tiborkiss/lora-tracker-kicad/träcker 01.pdf

# zukunftstag 2026

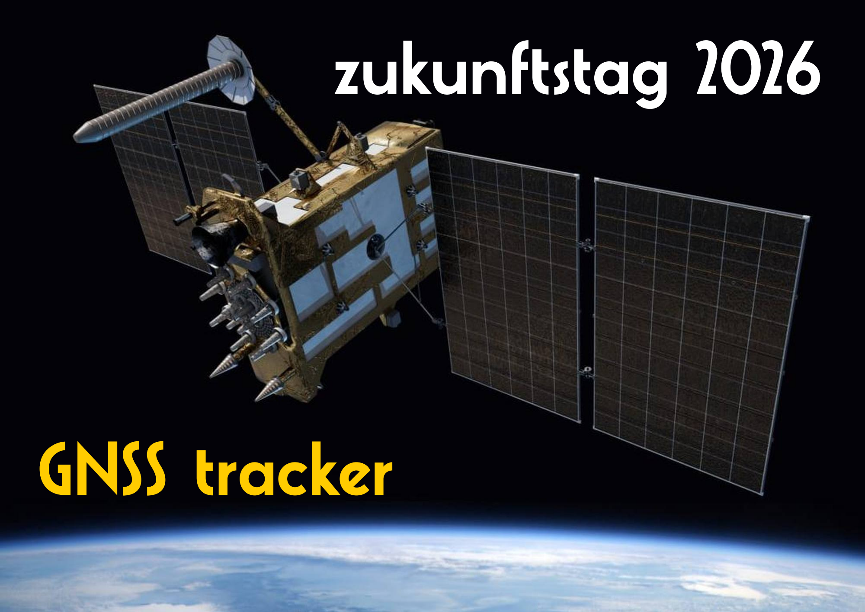
[picture p1: page 1]

# GNSS tracker

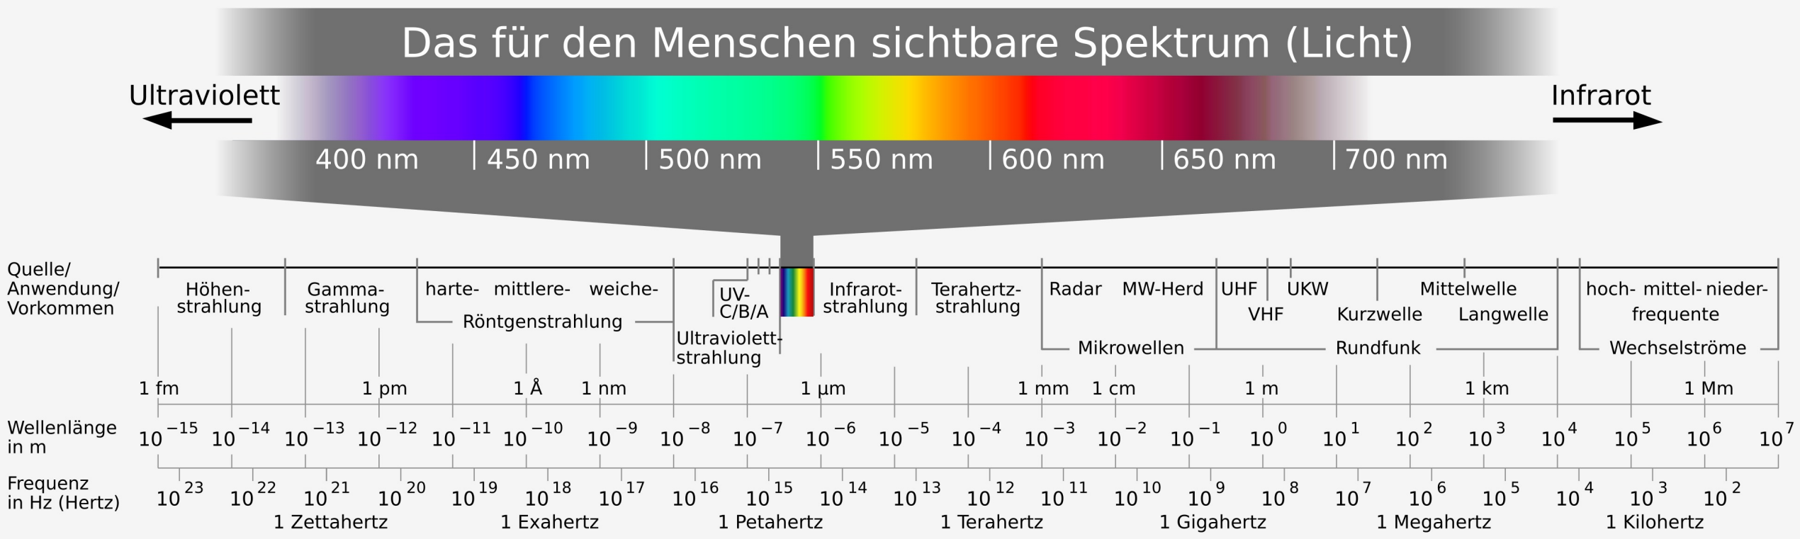
[picture p2: figure]

für den zukunftstag bauen wir einen tracker und einen empfänger. der tracker sendet seine position dem empfänger der diese in seinem display als zwei winkel anzeigt - azimut und deklination oder höhe und breite.

für die positionsbestimmung und die positionsübertragung nutzen wir elektromagnetische wellen.

ein teilspektrum der elektromagnetische wellen kann man sehen, dieser bereich ist licht. es hat sehr kurze wellenlängen < 1mikrometer.
die wellenlängen welches wir für die unser projekt nutzen sind im bereich von dezimeter.

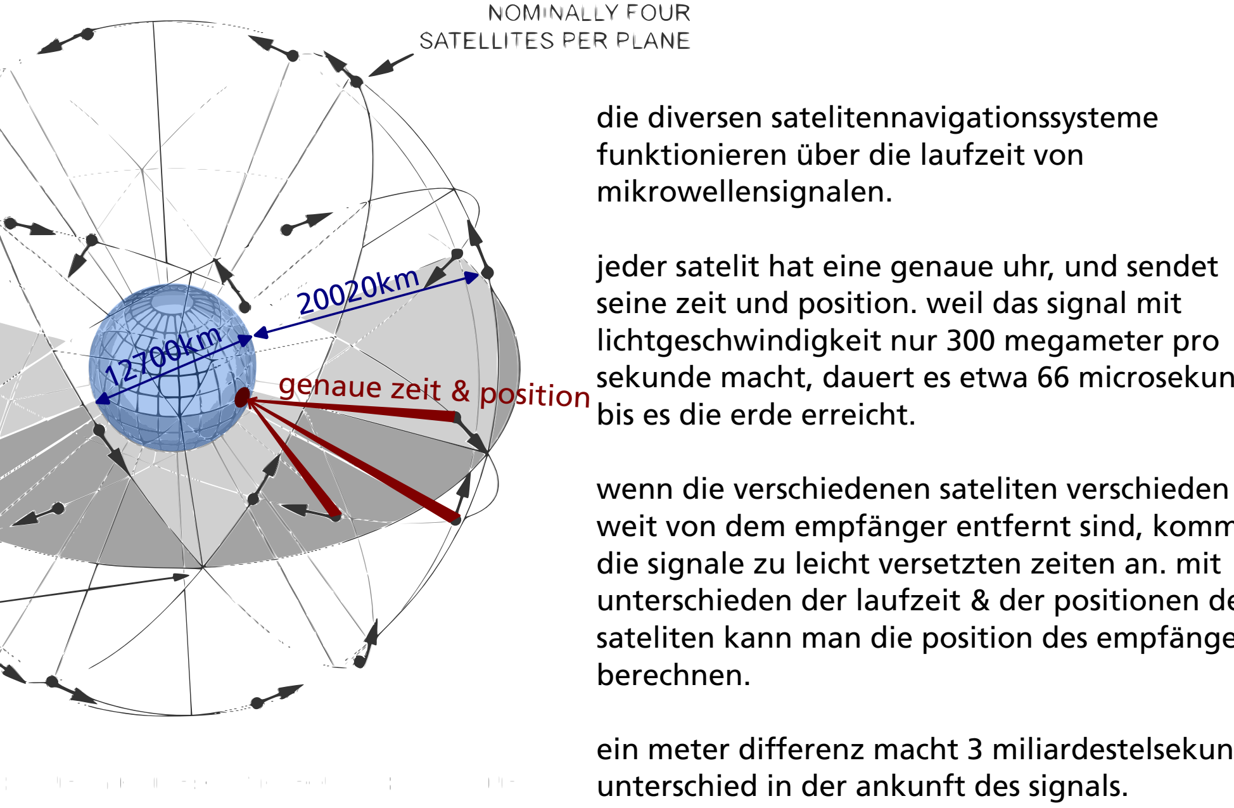
[picture p3: figure]
genaue zeit & position; die diversen satelitennavigationssysteme funktionieren über die laufzeit von mikrowellensignalen.; lichtgeschwindigkeit nur 300 megameter pro; bis es die erde erreicht.; wenn die verschiedenen sateliten verschieden; berechnen.; unterschied in der ankunft des signals.

jeder satelit hat eine genaue uhr, und sendet seine zeit und position. weil das signal mit

sekunde macht, dauert es etwa 66 microsekunden

weit von dem empfänger entfernt sind, kommen die signale zu leicht versetzten zeiten an. mit unterschieden der laufzeit & der positionen der sateliten kann man die position des empfängers

ein meter differenz macht 3 miliardestelsekunden für die übertragung der positiondaten muss der tracker selber senden.

es gibt einige frequenzbereiche welche frei verwendet werden dürfen, und mit diesen kann man kommunizieren ohne einen telefonanbieter oder eine behörde bezahlen zu müssen.

auf 989MHz kann man mit 0.5 watt strahlen und 100 zeichen pro sekunde bis 200km übertragen.

dies funktioniert nur wenn man freie sicht hat & eine freie fresnelzone. zum beispiel ein 30m freier radius für 10km distanz.

wenn objekte in diesem bereich sind, wird eine teil der gesendeten elektromagnetischen leistung absorbiert und in wärme verwandelt, oder in eine andere richtung abgelenkt. damit wird die mögliche übertragnungsdistanz kleiner, denn das signal geht im rauschen unter.

30m

10km

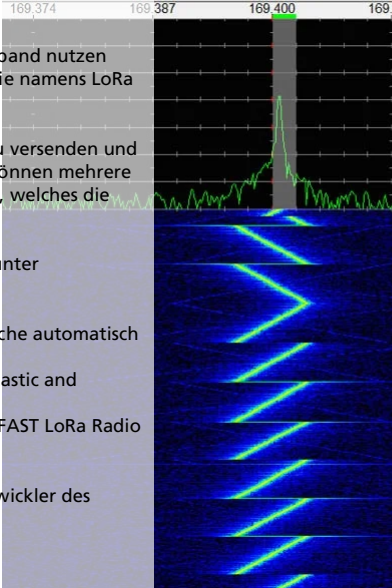
[picture p4: figure]

das funkprotokoll welches wir auf dem gratisband nutzen heisst mestastic. es verwendet eine technologie namens LoRa (long range).

das protokoll ermöglicht kurze nachrichten zu versenden und empfangene nachrichten weiterzuleiten. so können mehrere mestastic geräte spontan ein netzwerk bilden, welches die mögliche übertragnungsdistanz vervielfacht.

informationen zu dem protokoll findet man unter

1. https://swiss-mesh.ch/de/
2. viele vidos auf youtube.com (untertitel welche automatisch übersetzt werden können)
"Intro to LoRa Mesh Part 1: What are Meshtastic and MeshCore?"
"Meshtastic Signal Identification for LONG_FAST LoRa Radio Presets on SDR"
3. https://meshtastic.org/ (english)
4. https://www.semtech.com/lora (english entwickler des protokolls)

## Bestückung Tracker

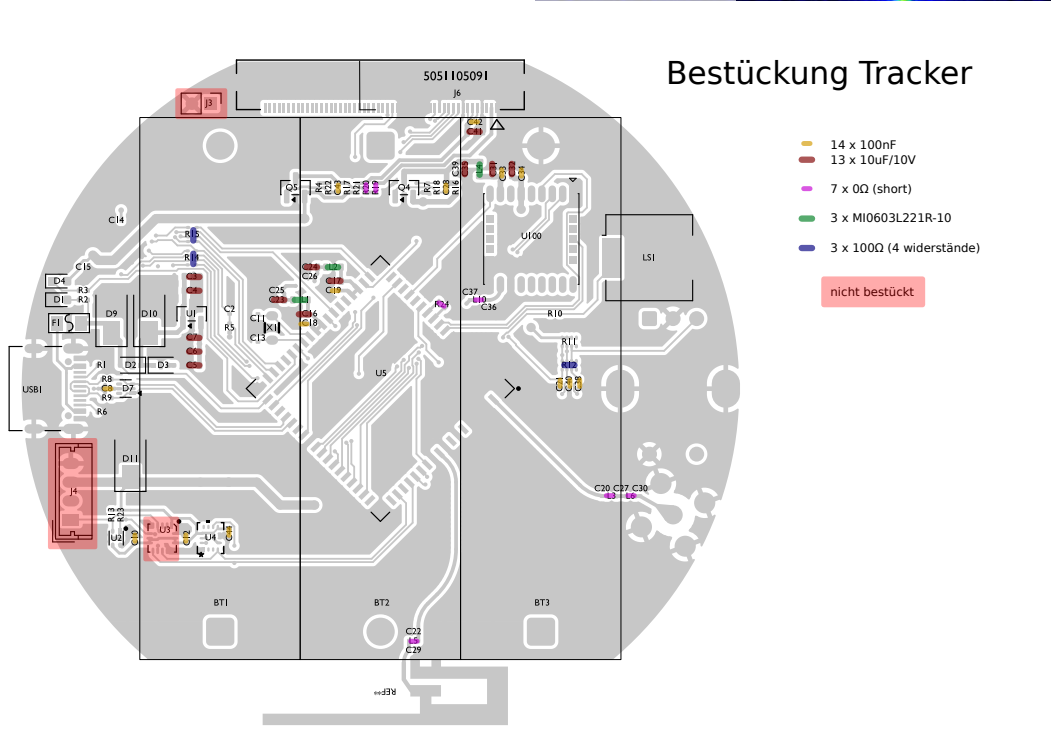
[picture p5: page 6]
7 x 0Ω (short); 3 x 100Ω (4 widerstände); nicht bestückt

## Bestückung Empfänger

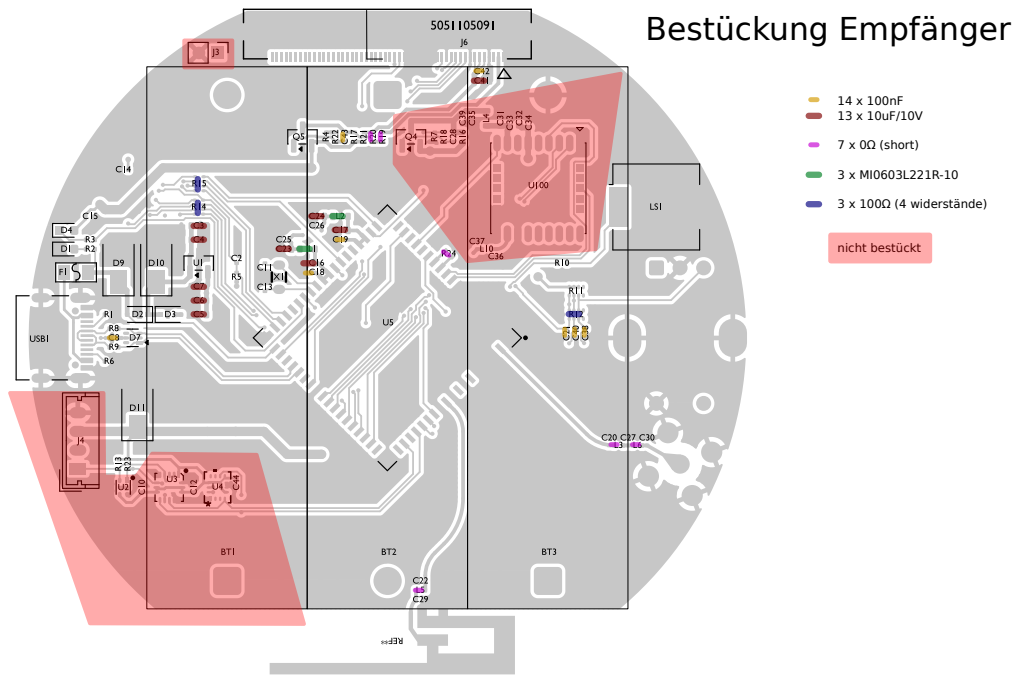
[picture p6: page 7]
7 x 0Ω (short); 3 x 100Ω (4 widerstände); nicht bestückt

Qty | Value | Reference | Footprint
| | orientierung egal
14 | 100n | C8,C10,C12,C18,C19,C21,C28,C33,C34,C38,C40,C42,C43,C44 | CSC01:0402_C
13 | 10u/10V | C3,C4,C5,C6,C7,C16,C17,C23,C24,C31,C32,C35,C41 | CSC01:0603_C
4 | SHORT | L3,L5,L6,L10 | CSC01:0402_L
4 | 2k2 | R13,R18,R22,R23 | CSC01:0402_R
3 | SHORT | R19,R20,R24 | CSC01:0402_R
3 | MI0603L221R-10 | L1,L2,L4 | CSC01:0603_L
3 | 100 | R12,R14,R15 | CSC01:0804-8
2 | 1p0 | C11,C13 | CSC01:0402_C
2 | GSEZ7B002 | C30,C37 | CSC01:0402_C
2 | 22 | R8,R9 | CSC01:0402_R
2 | 220 | R3,R10 | CSC01:0402_R
2 | 100k | R4,R7 | CSC01:0402_R
2 | 5k1 | R1,R6 | CSC01:0402_R
1 | 1k | R2 | CSC01:0402_R
1 | 10k | R11 | CSC01:0804-8
1 | SC32S-7PF20PPM | X1 | CSC01:XTAL2-1.5X3.2
1 | 0ZCJ0025FF2E | F1 | demo:FS1206
1 | CPT-9019 | LS1 | BuzzerCUI_CPT-9019S-SMT
| | polarisiert
2 | B0530WS RRG | D2,D3 | CSC01:D_SOD-323F
2 | SMAJ5.0A | D9,D10 | Diode_SMD:D_SMA
2 | IN-S63AT5A | D1,D4 | LED_0603_1608Metric
1 | D5V0F4U6V | D7 | SOT-563
1 | SMBJ3V3-E3/52 | D11 | Diode_SMD:D_SMA
2 | SLMT320V3CP | Q4,Q5 | Package_TO_SOT_SMD:SOT-23

1 | LC76G | U100 | 000:LC76G
1 | BMI270 | U4 | 000:BMI270_BOS
1 | SHT41 | U2 | demo:SNR4-0.8-1.5X1.5X0.54MM
1 | WM1110-A_01 | U5 | MODULE72_0D9_20X20X2MM
1 | AP7333-33SAG-7 | U1 | Package_TO_SOT_SMD:SOT-23
1 | UBF31-0171 | USB1 | demo:USB2.0-TYPE-C
1 | 5051102891 | J6 | 000:CON_5051105091_MOL
| | erst nach reflow löten besücken
3 | Battery_Cell AA | BT1,BT2,BT3 | GNSS_tracker:keystone_2460
1 | PEC12R-4222F-S0024 | SW3 | 000:RotaryEncoder
1 | Conn_Coaxial | J2 | Connector_Coaxial:SMA
1 | ANT 2525 B 00B T 15AE1 | ANT 2525 B 00B T 1575S
| | nicht bestückt
11 | NC | C2,C14,C15,C20,C22,C25,C26,C27,C29,C36,C39 | CSC01:0402_C
4 | NC | R5,R16,R17,R21 | CSC01:0402_R
1 | NC | J4 | Connector_Molex:Molex
1 | NC | J1 | Connector_PinHeader_1.27mm
1 | NC | J3 | Connector_PinHeader_2.00mm
1 | NC (H3LIS331DL) | U3 | demo:LGA16-0.5-3X3MM

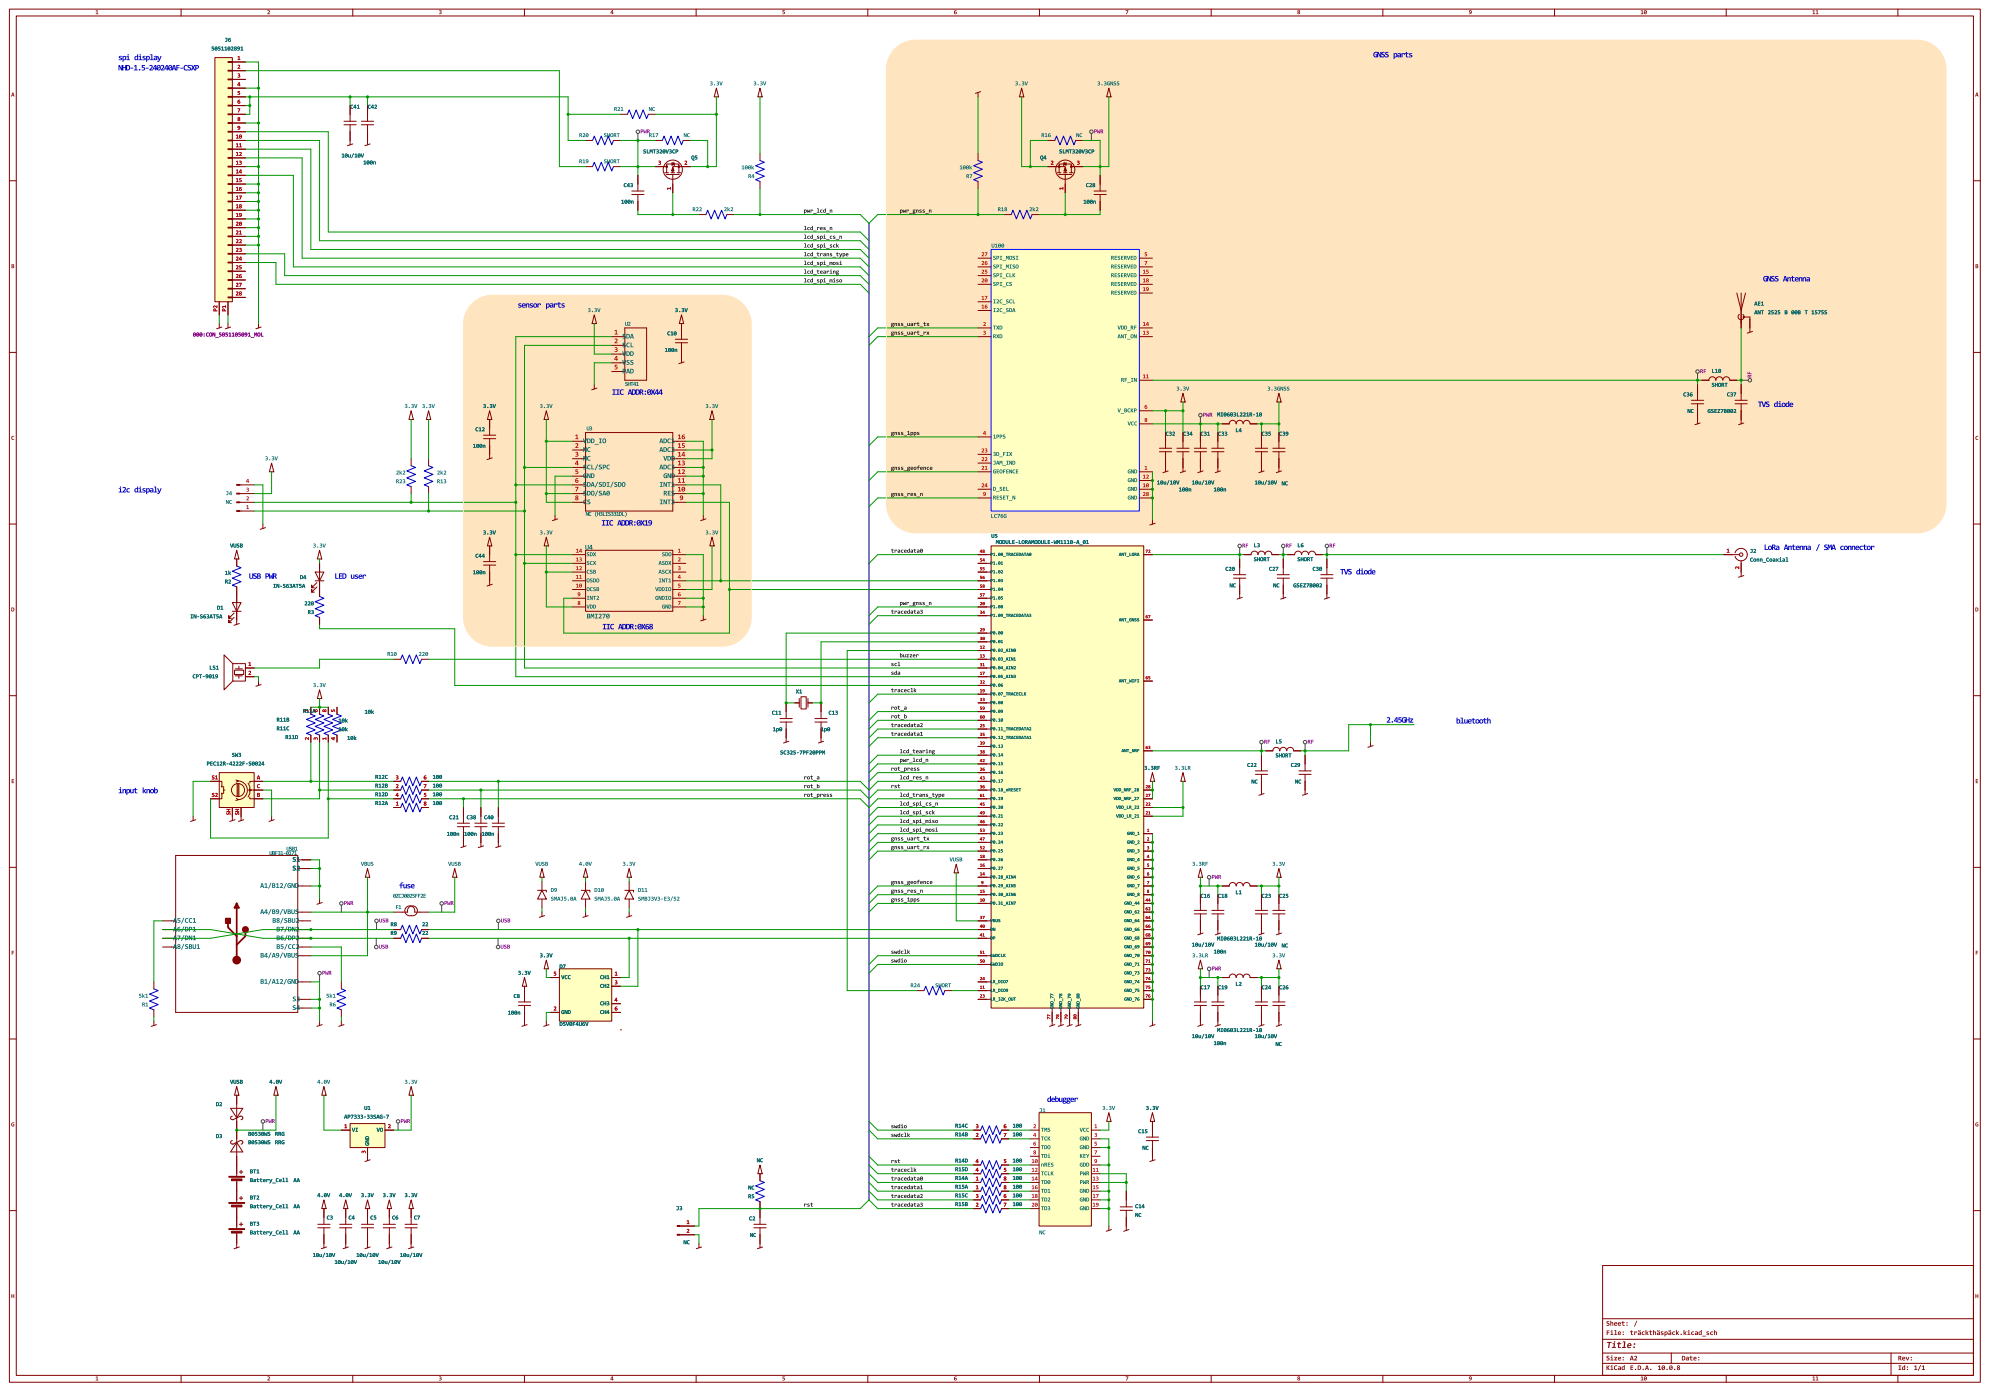
[picture p7: page 10]
