tiborkiss/lora-tracker-kicad/träckthäspäck.csv

Qty | Reference | Value | Footprint
 | orientierung egal
14 | C8,C10,C12,C18,C19,C21,C28,C33,C34,C38,C40,C42,C43,C44 | 100n | CSC01:0402_C
13 | C3,C4,C5,C6,C7,C16,C17,C23,C24,C31,C32,C35,C41 | 10u/10V | CSC01:0603_C
4 | L3,L5,L6,L10 | SHORT | CSC01:0402_L
4 | R13,R18,R22,R23 | 2k2 | CSC01:0402_R
3 | R19,R20,R24 | SHORT | CSC01:0402_R
3 | L1,L2,L4 | MI0603L221R-10 | CSC01:0603_L
3 | R12,R14,R15 | 100 | CSC01:0804-8
2 | C11,C13 | 1p0 | CSC01:0402_C
2 | C30,C37 | GSEZ7B002 | CSC01:0402_C
2 | R8,R9 | 22 | CSC01:0402_R
2 | R3,R10 | 220 | CSC01:0402_R
2 | R4,R7 | 100k | CSC01:0402_R
2 | R1,R6 | 5k1 | CSC01:0402_R
1 | R2 | 1k | CSC01:0402_R
1 | R11 | 10k | CSC01:0804-8
1 | X1 | SC32S-7PF20PPM | CSC01:XTAL2-1.5X3.2
1 | F1 | 0ZCJ0025FF2E | demo:FS1206
1 | LS1 | CPT-9019 | Buzzer_Beeper:Buzzer_CUI_CPT-9019S-SMT
 | polarisiert
2 | D2,D3 | B0530WS RRG | CSC01:D_SOD-323F
2 | D9,D10 | SMAJ5.0A | Diode_SMD:D_SMA
2 | D1,D4 | IN-S63AT5A | LED_SMD:LED_0603_1608Metric
1 | D7 | D5V0F4U6V | SOT-563
1 | D11 | SMBJ3V3-E3/52 | Diode_SMD:D_SMA
2 | Q4,Q5 | SLMT320V3CP | Package_TO_SOT_SMD:SOT-23
1 | U100 | LC76G | 000:LC76G
1 | U4 | BMI270 | 000:BMI270_BOS
1 | U2 | SHT41 | demo:SNR4-0.8-1.5X1.5X0.54MM
1 | U5 | MODULE-LORAMODULE-WM1110-A_01 | MODULE72_0D9_20X20X2MM
1 | U1 | AP7333-33SAG-7 | Package_TO_SOT_SMD:SOT-23
1 | USB1 | UBF31-0171 | demo:USB2.0-TYPE-C
1 | J6 | 5051102891 | 000:CON_5051105091_MOL
 | erst nach reflow löten besücken
3 | BT1,BT2,BT3 | Battery_Cell AA | GNSS_tracker:keystone_2460
1 | SW3 | PEC12R-4222F-S0024 | 000:RotaryEncoder_Bourns_Vertical_PEC12R-3x17F-S--oli
1 | J2 | Conn_Coaxial | Connector_Coaxial:SMA_Amphenol_132134_Vertical
1 | AE1 | ANT 2525 B 00B T 1575S | GNSS_tracker:ANT 2525 B 00B T 1575S
 | nicht bestückt
11 | C2,C14,C15,C20,C22,C25,C26,C27,C29,C36,C39 | NC | CSC01:0402_C
4 | R5,R16,R17,R21 | NC | CSC01:0402_R
1 | J4 | NC | Connector_Molex:Molex_Micro-Latch_53253-0470_1x04_P2.00mm_Vertical
1 | J1 | NC | Connector_PinHeader_1.27mm:PinHeader_2x10_P1.27mm_Vertical_SMD
1 | J3 | NC | Connector_PinHeader_2.00mm:PinHeader_1x02_P2.00mm_Vertical
1 | U3 | NC (H3LIS331DL) | demo:LGA16-0.5-3X3MM
