tiborkiss/lora-tracker-kicad/träckthäspäck.kicad_pcb

## KiCad design träckthäspäck.kicad_pcb (2026-11-12)

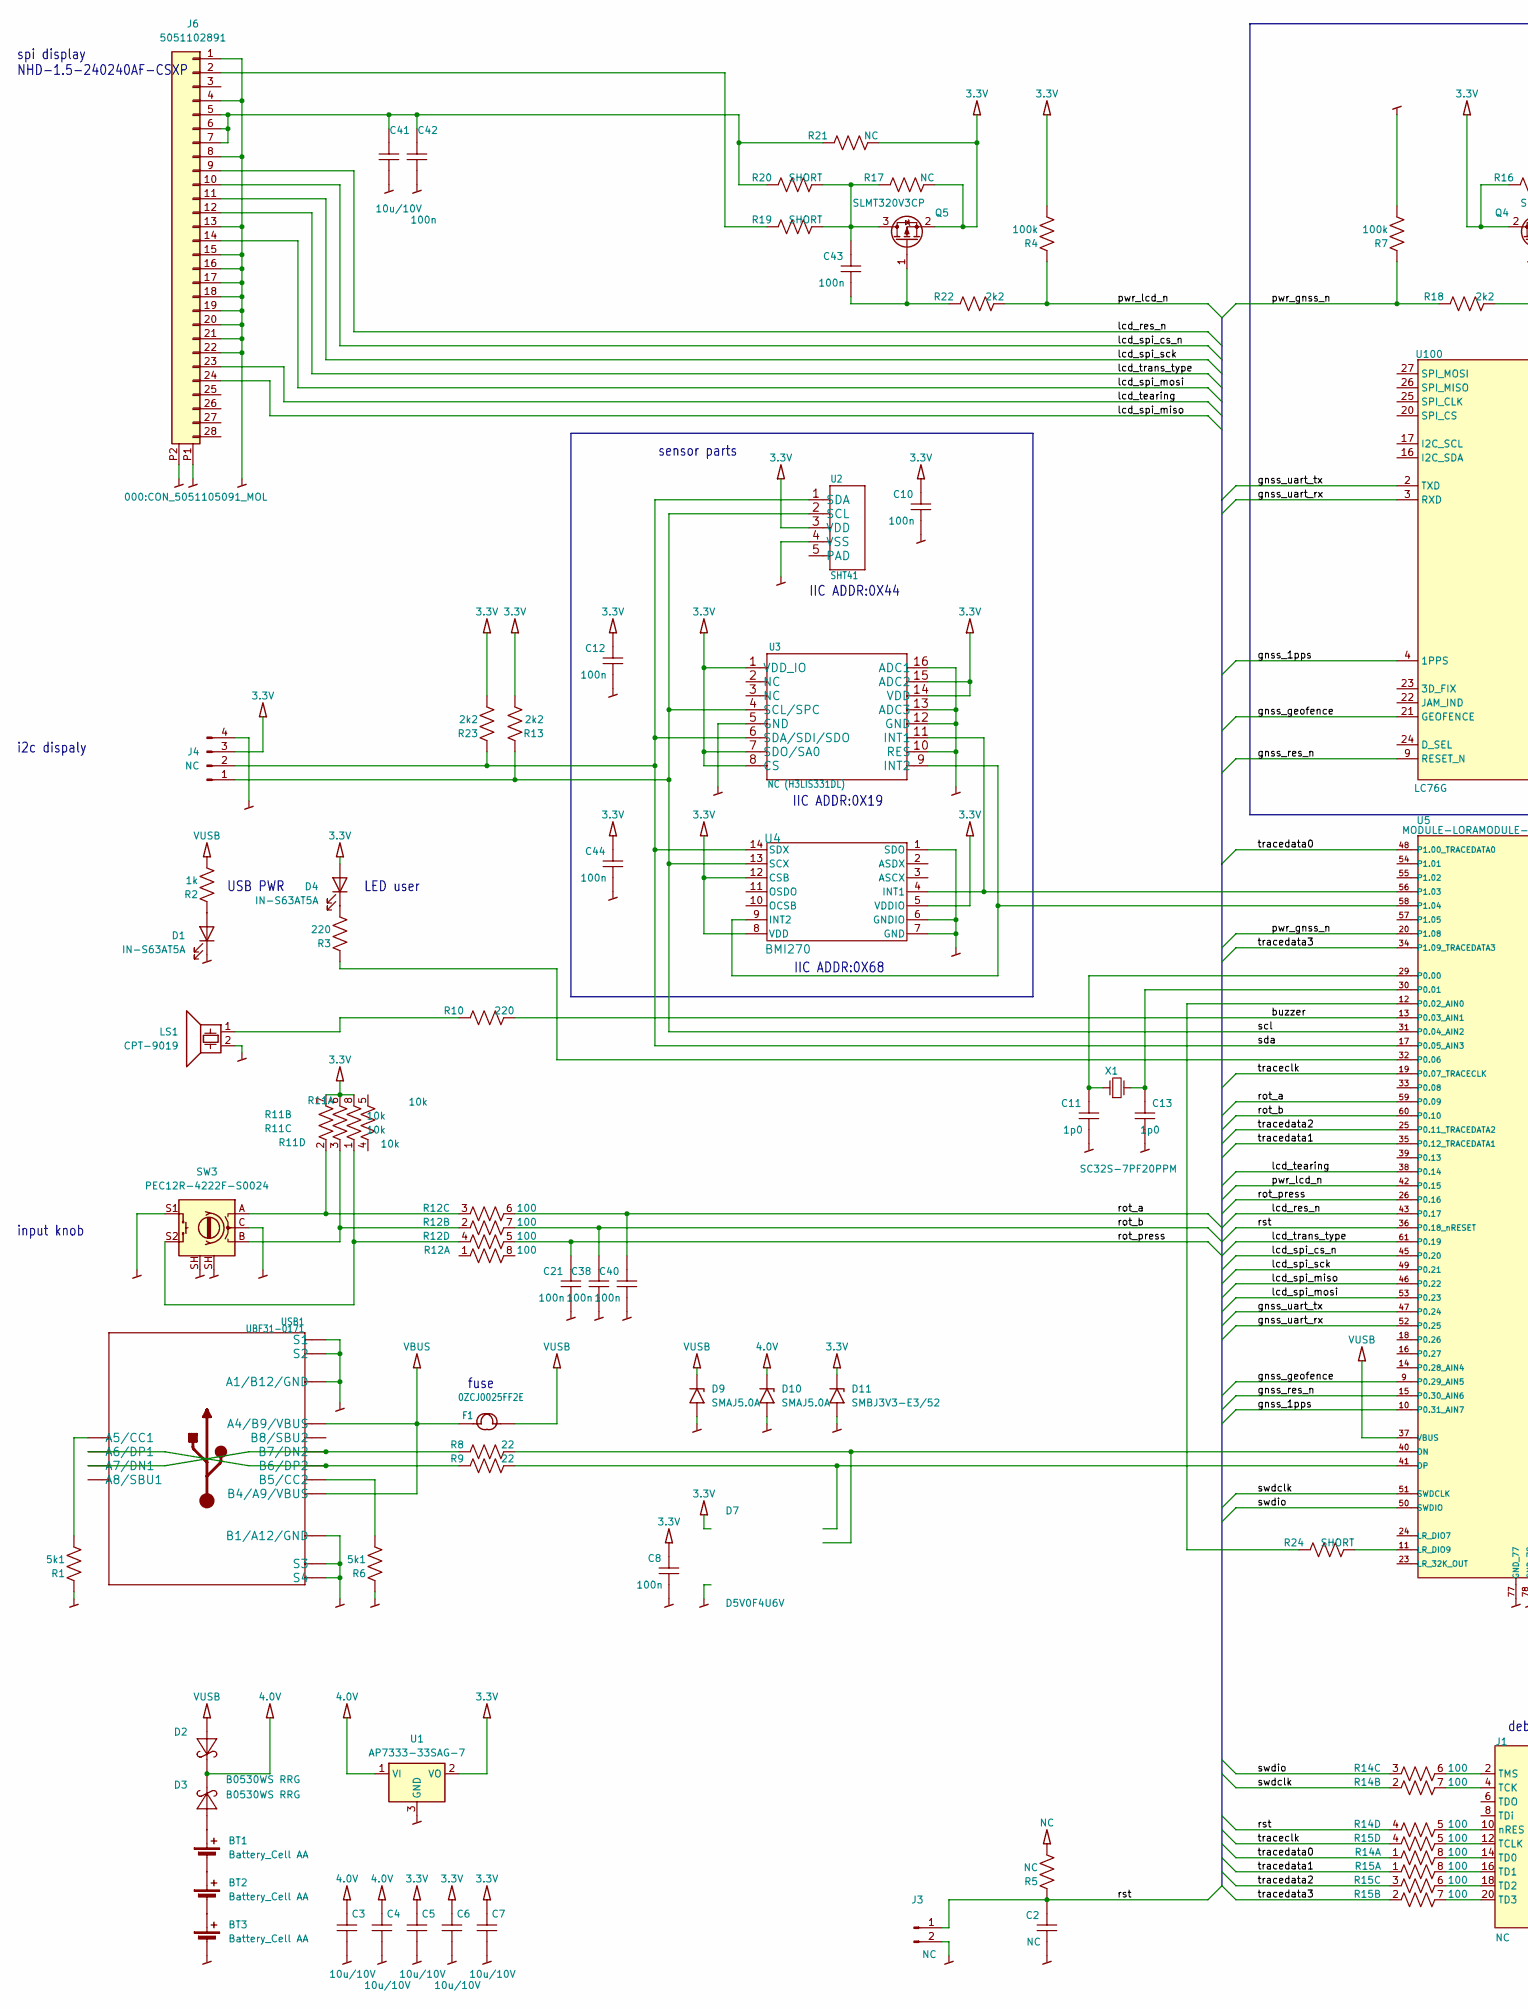
[picture p8: schematic träckthäspäck.kicad_sch, part in row 1, column 1]

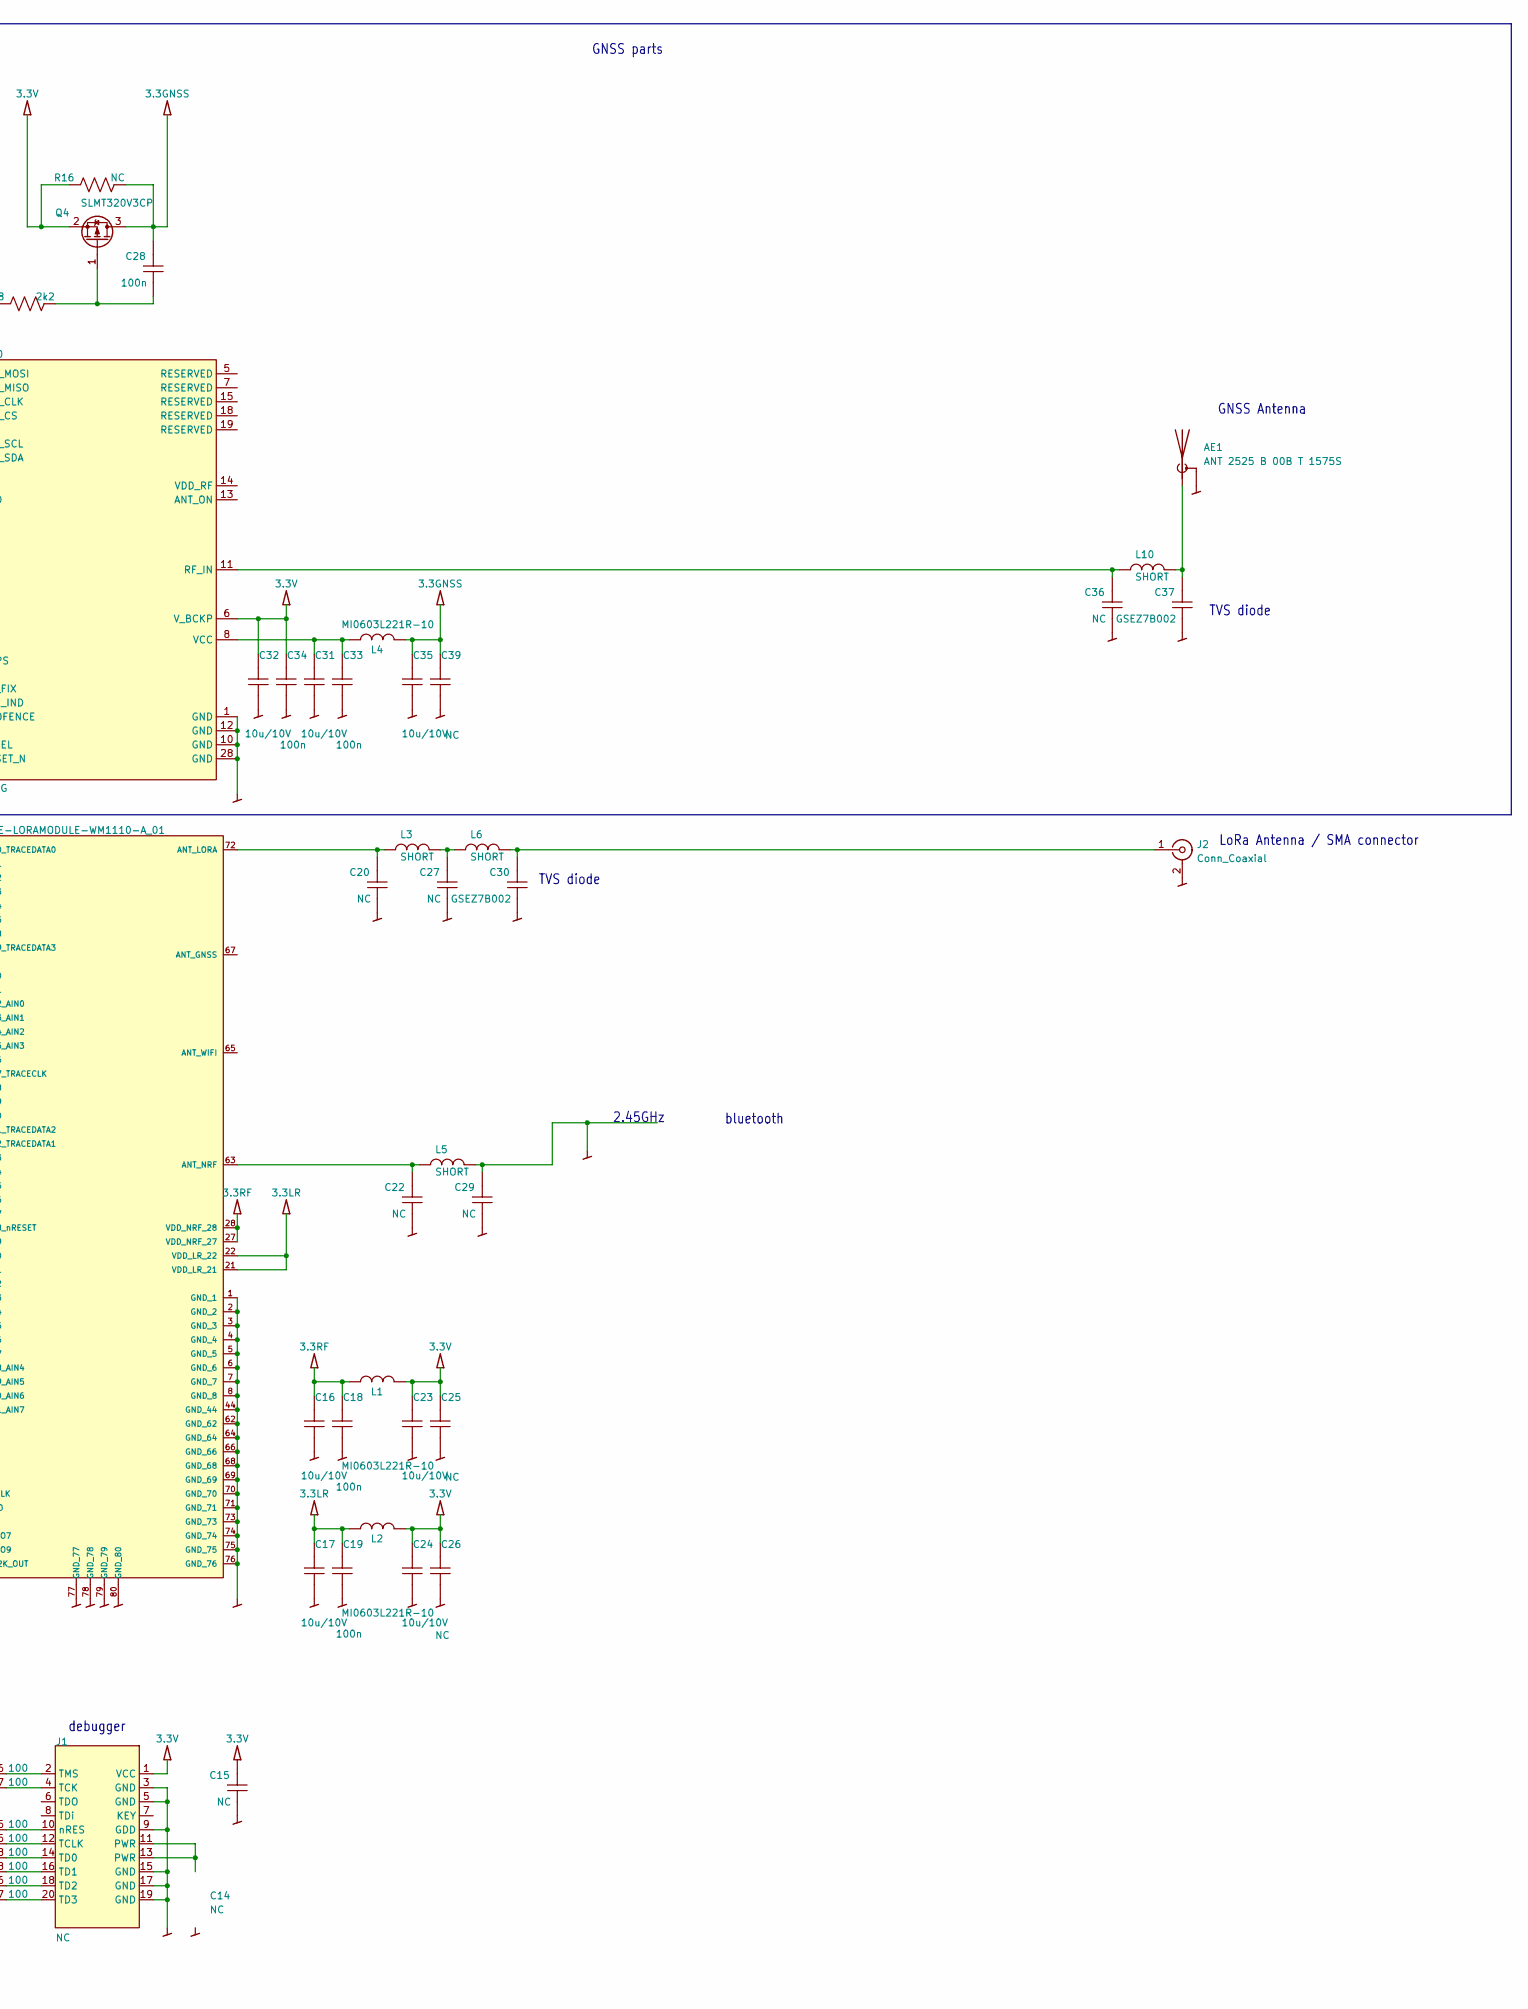
[picture p9: schematic träckthäspäck.kicad_sch, part in row 1, column 2]

Parts:
AE1: ANT 2525 B 00B T 1575S
BT1, BT2, BT3: Battery_Cell AA; keystone_2460
C2, C14, C15, C20, C22, C25, C26, C27, C29, C36, C39: NC; 0402_C
C3, C4, C5, C6, C7, C16, C17, C23, C24, C31, C32, C35, C41: 10u/10V; 0603_C
C8, C10, C12, C18, C19, C21, C28, C33, C34, C38, C40, C42, C43, C44: 100n; 0402_C
C11, C13: 1p0; 0402_C
C30, C37: GSEZ7B002; 0402_C
D1, D4: IN-S63AT5A; LED_0603_1608Metric
D2, D3: B0530WS RRG; D_SOD-323F
D7: D5V0F4U6V; SOT-563
D9, D10: SMAJ5.0A; D_SMA
D11: SMBJ3V3-E3/52; D_SMA
F1: 0ZCJ0025FF2E; FS1206
J1: NC; PinHeader_2x10_P1.27mm_Vertical_SMD
J2: Conn_Coaxial; SMA_Amphenol_132134_Vertical
J3: NC; PinHeader_1x02_P2.00mm_Vertical
J4: NC; Molex_Micro-Latch_53253-0470_1x04_P2.00mm_Vertical
J6: 5051102891; CON_5051105091_MOL
L1, L2, L4: MI0603L221R-10; 0603_L
L3, L5, L6, L10: SHORT; 0402_L
LS1: CPT-9019; Buzzer_CUI_CPT-9019S-SMT
Q4, Q5: SLMT320V3CP; SOT-23
R1, R6: 5k1; 0402_R
R2: 1k; 0402_R
R3, R10: 220; 0402_R
R4, R7: 100k; 0402_R
R5, R16, R17, R21: NC; 0402_R
R8, R9: 22; 0402_R
R11: 10k; 0804-8
R12, R14, R15: 100; 0804-8
R13, R18, R22, R23: 2k2; 0402_R
R19, R20, R24: SHORT; 0402_R
SW3: PEC12R-4222F-S0024; RotaryEncoder_Bourns_Vertical_PEC12R-3x17F-S--oli
U1: AP7333-33SAG-7; SOT-23
U2: SHT41; SNR4-0.8-1.5X1.5X0.54MM
U3: NC (H3LIS331DL); LGA16-0.5-3X3MM
U4: BMI270; BMI270_BOS
U5: MODULE-LORAMODULE-WM1110-A_01; MODULE72_0D9_20X20X2MM
U100: LC76G
USB1: UBF31-0171; USB2.0-TYPE-C
X1: SC32S-7PF20PPM; XTAL2-1.5X3.2

Connections:
3.3GNSS: C28.1, C35.1, C39.1, L4.1, Q4.3 (D), R16.1
3.3LR: C17.1, C19.1, L2.2, U5.21 (VDD_LR_21), U5.22 (VDD_LR_22)
3.3RF: C16.1, C18.1, L1.2, U5.27 (VDD_NRF_27), U5.28 (VDD_NRF_28)
3.3V: C5.1, C6.1, C7.1, C8.1, C10.1, C12.1, C15.1, C23.1, C24.1, C25.1, C26.1, C32.1, C34.1, C44.1, D4.2 (A), D7.5 (VCC), D11.1 (A1), J1.1 (VCC), J4.3, L1.1, L2.1, Q4.2 (S), Q5.2 (S), R4.1, R11.6 (2), R11.7 (2), R11.8 (2), R13.1, R16.2, R17.1, R21.1, R23.1, U1.2 (VO), U2.3 (VDD), U3.1 (VDD_IO), U3.7 (SDO/SA0), U3.8 (CS), U3.14 (VDD), U3.15 (ADC2), U4.5 (VDDIO), U4.8 (VDD), U4.12 (CSB), U100.6 (V_BCKP)
4.0V: C3.1, C4.1, D2.1, D3.1, D10.1 (A1), U1.1 (VI)
/buzzer: R10.1, U5.13 (P0.03_AIN1)
/gnss_1pps: U5.10 (P0.31_AIN7), U100.4 (1PPS)
/gnss_geofence: U5.9 (P0.29_AIN5), U100.21 (GEOFENCE)
/gnss_res_n: U5.15 (P0.30_AIN6), U100.9 (RESET_N)
/gnss_uart_rx: U5.52 (P0.25), U100.3 (RXD)
/gnss_uart_tx: U5.47 (P0.24), U100.2 (TXD)
/lcd_res_n: J6.9, U5.43 (P0.17)
/lcd_spi_cs_n: J6.10, U5.45 (P0.20)
/lcd_spi_miso: J6.24, U5.46 (P0.22)
/lcd_spi_mosi: J6.14, U5.53 (P0.23)
/lcd_spi_sck: J6.11, U5.49 (P0.21)
/lcd_tearing: J6.23, U5.38 (P0.14)
/lcd_trans_type: J6.12, U5.61 (P0.19)
/pwr_gnss_n: R7.2, R18.2, U5.20 (P1.08)
/pwr_lcd_n: R4.2, R22.1, U5.42 (P0.15)
/rot_a: C40.1, R12.6 (2), U5.59 (P0.09)
/rot_b: C38.1, R12.7 (2), U5.60 (P0.10)
/rot_press: C21.1, R12.5 (2), U5.26 (P0.16)
/rst: C2.1, J3.1, R5.2, R14.4 (1), U5.36 (P0.18_nRESET)
/scl: J4.1, R13.2, U2.2 (SCL), U3.4 (SCL/SPC), U4.13 (SCX), U5.31 (P0.04_AIN2)
/sda: J4.2, R23.2, U2.1 (SDA), U3.6 (SDA/SDI/SDO), U4.14 (SDX), U5.17 (P0.05_AIN3)
/swdclk: R14.2 (1), U5.51 (SWDCLK)
/swdio: R14.3 (1), U5.50 (SWDIO)
/traceclk: R15.4 (1), U5.19 (P0.07_TRACECLK)
/tracedata0: R14.1, U5.48 (P1.00_TRACEDATA0)
/tracedata1: R15.1, U5.35 (P0.12_TRACEDATA1)
/tracedata2: R15.3 (1), U5.25 (P0.11_TRACEDATA2)
/tracedata3: R15.2 (1), U5.34 (P1.09_TRACEDATA3)
GND: AE1.2 (Shield), BT3.2 (-), C2.2, C3.2, C4.2, C5.2, C6.2, C7.2, C8.2, C10.2, C11.2, C12.2, C13.2, C14.2, C15.2, C16.2, C17.2, C18.2, C19.2, C20.2, C21.2, C22.2, C23.2, C24.2, C25.2, C26.2, C27.2, C29.2, C30.2, C31.2, C32.2, C33.2, C34.2, C35.2, C36.2, C37.2, C38.2, C39.2, C40.2, C41.2, C42.2, C44.2, D1.1 (K), D7.2 (GND), D9.2 (A2), D10.2 (A2), D11.2 (A2), J1.3 (GND), J1.5 (GND), J1.9 (GDD), J1.15 (GND), J1.17 (GND), J1.19 (GND), J2.2 (Ext), J3.2, J4.4, J6.1, J6.4, J6.8, J6.13, J6.15, J6.16, J6.17, J6.18, J6.19, J6.20, J6.21, J6.22, J6.P1, J6.P2, LS1.2, R1.2, R6.2, R7.1, SW3.C, SW3.S1, SW3.SH, U1.3 (GND), U2.4 (VSS), U3.5 (GND), U3.10 (RES), U3.12 (GND), U3.13 (ADC3), U3.16 (ADC1), U4.1 (SDO), U4.6 (GNDIO), U4.7 (GND), U5.1 (GND_1), U5.2 (GND_2), U5.3 (GND_3), U5.4 (GND_4), U5.5 (GND_5), U5.6 (GND_6), U5.7 (GND_7), U5.8 (GND_8), U5.44 (GND_44), U5.62 (GND_62), U5.64 (GND_64), U5.66 (GND_66), U5.68 (GND_68), U5.69 (GND_69), U5.70 (GND_70), U5.71 (GND_71), U5.73 (GND_73), U5.74 (GND_74), U5.75 (GND_75), U5.76 (GND_76), U5.77 (GND_77), U5.78 (GND_78), U5.79 (GND_79), U5.80 (GND_80), U100.1 (GND), U100.10 (GND), U100.12 (GND), U100.28 (GND), USB1.A1_B12 (A1/B12/GND), USB1.B1_A12 (B1/A12/GND), USB1.S1, USB1.S2, USB1.S3, USB1.S4, USB1.S5 (S1), USB1.S6 (S2)
GND_A2: C29.1, L5.1
NC: R5.1
unnamed: AE1.1 (A), C37.1, L10.1
unnamed: BT1.1 (+), D3.2
unnamed: BT1.2 (-), BT2.1 (+)
unnamed: BT2.2 (-), BT3.1 (+)
unnamed: C14.1, J1.11 (PWR), J1.13 (PWR)
unnamed: C27.1, L3.1, L6.2
unnamed: D1.2 (A), R2.2
unnamed: D4.1 (K), R3.1
unnamed: D7.1 (CH1), R9.1, U5.41 (DP)
unnamed: D7.3 (CH2), R8.1, U5.40 (DN)
unnamed: J1.4 (TCK), R14.7 (2)
unnamed: J1.12 (TCLK), R15.5 (2)
unnamed: J1.14 (TD0), R14.8 (2)
unnamed: J1.16 (TD1), R15.8 (2)
unnamed: J1.18 (TD2), R15.6 (2)
unnamed: J1.20 (TD3), R15.7 (2)
unnamed: J1.2 (TMS), R14.6 (2)
unnamed: J1.10 (nRES), R14.5 (2)
unnamed: C30.1, J2.1 (In), L6.1
unnamed: J6.2, R19.2
unnamed: C41.1, C42.1, J6.5, J6.6, J6.7, R20.2, R21.2
unnamed: LS1.1, R10.2
unnamed: C28.2, Q4.1 (G), R18.1
unnamed: C43.1, Q5.3 (D), R17.2, R19.1, R20.1
unnamed: C43.2, Q5.1 (G), R22.2
unnamed: R11.2 (1), R12.3 (1), SW3.A
unnamed: R11.3 (1), R12.2 (1), SW3.B
unnamed: R11.1, R12.4 (1), SW3.S2
unnamed: U3.11 (INT1), U4.4 (INT1), U5.56 (P1.03)
unnamed: U3.9 (INT2), U4.9 (INT2), U5.58 (P1.04)
unnamed: C20.1, L3.2, U5.72 (ANT_LORA)
unnamed: C22.1, L5.2, U5.63 (ANT_NRF)
unnamed: R24.1, U5.11 (LR_DIO9)
unnamed: C11.1, U5.29 (P0.00), X1.2
unnamed: C13.1, U5.30 (P0.01), X1.1
unnamed: R24.2, U5.12 (P0.02_AIN0)
unnamed: R3.2, U5.32 (P0.06)
unnamed: C36.1, L10.2, U100.11 (RF_IN)
unnamed: C31.1, C33.1, L4.2, U100.8 (VCC)
unnamed: R1.1, USB1.A5 (A5/CC1)
unnamed: R9.2, USB1.A6 (A6/DP1), USB1.B6 (B6/DP2)
unnamed: R8.2, USB1.A7 (A7/DN1), USB1.B7 (B7/DN2)
unnamed: R6.1, USB1.B5 (B5/CC2)
VBUS: F1.1, USB1.A4_B9 (A4/B9/VBUS), USB1.B4_A9 (B4/A9/VBUS)
VUSB: D2.2, D9.1 (A1), F1.2, R2.1, U5.37 (VBUS)

Notes on the sheet:
sensor parts
2.45GHz
TVS diode
GNSS Antenna
fuse
spi display NHD-1.5-240240AF-CSXP
LED user
IIC ADDR:0X44
IIC ADDR:0X68
USB PWR
bluetooth
IIC ADDR:0X19
LoRa Antenna / SMA connector
i2c dispaly
input knob
debugger
GNSS parts

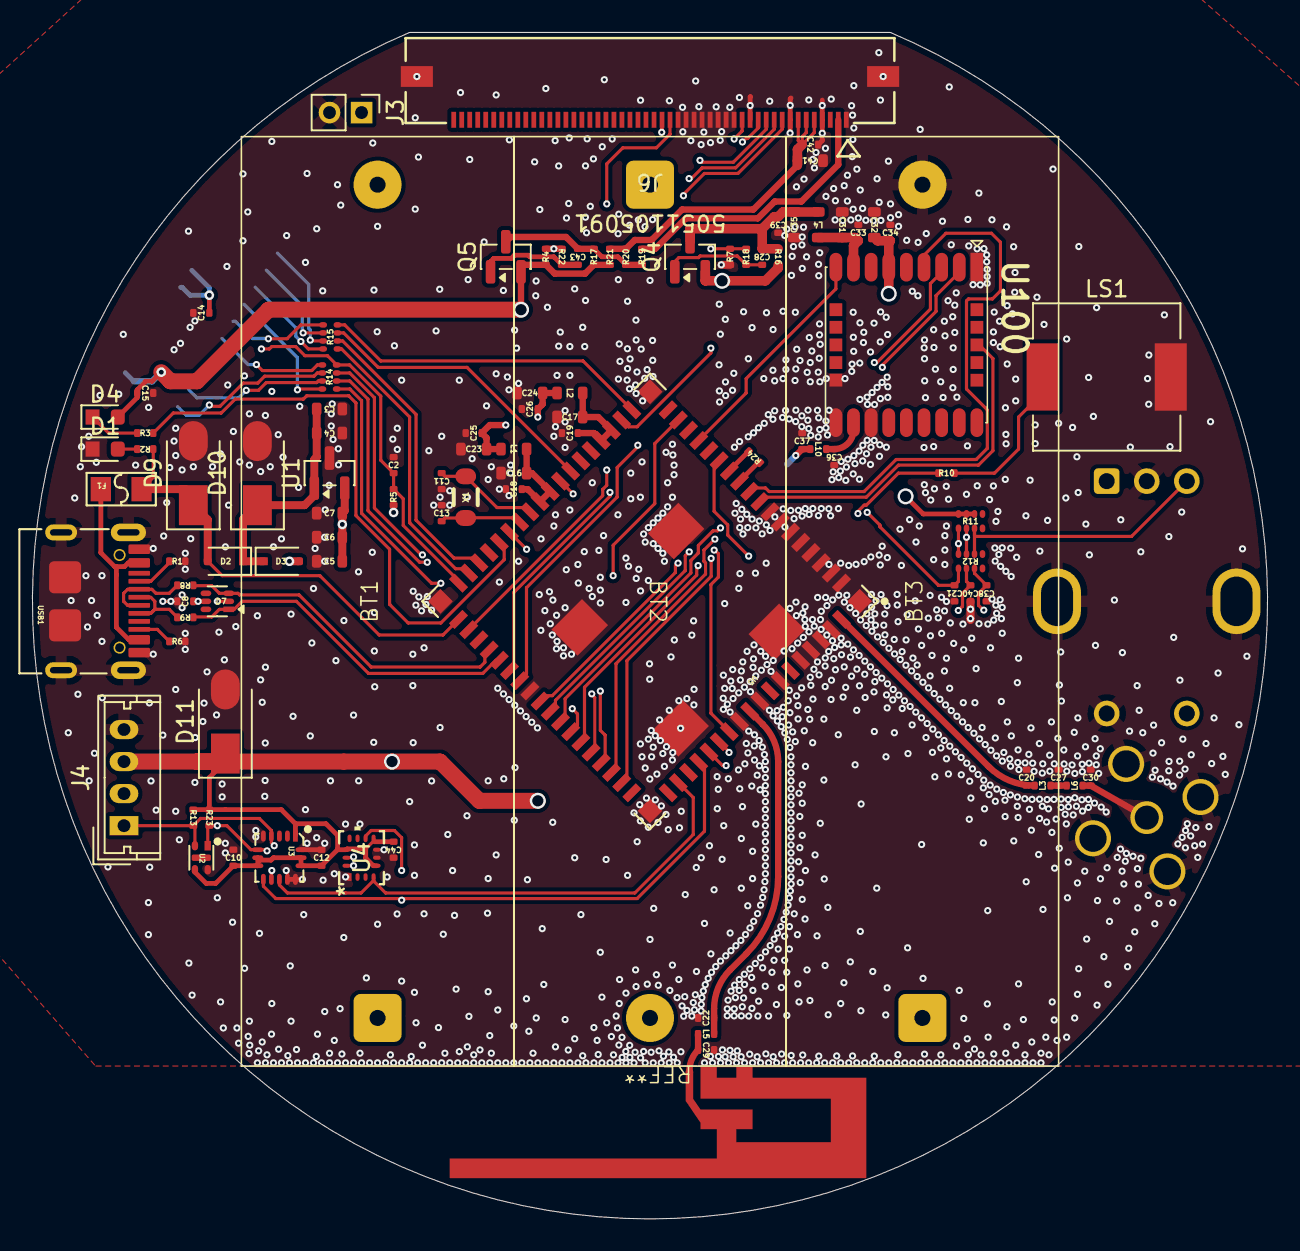
[picture p10: board träckthäspäck.kicad_pcb from above]

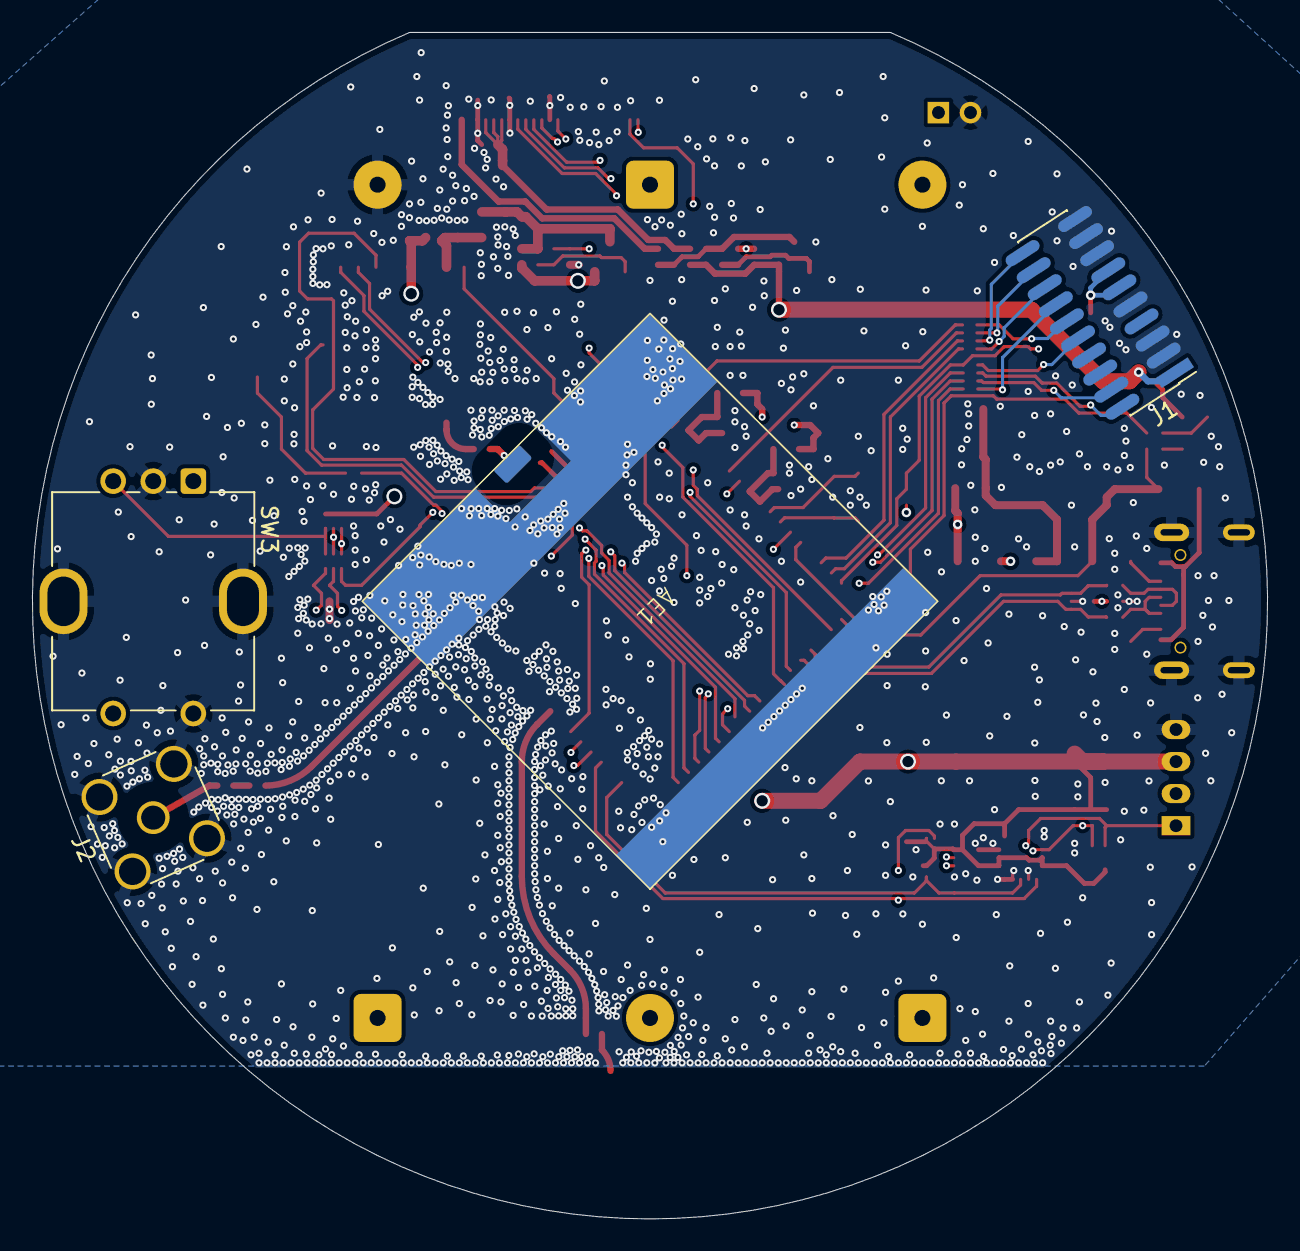
[picture p11: board träckthäspäck.kicad_pcb from below]

Board: 4 copper layers, 77.1 x 74.0 mm, 103 parts (4 on the bottom side), 80 nets.
