tiborkiss/lora-tracker-kicad/(commit log)

2026-11-04 Final version as V9
    [träckthäspäck.kicad_pcb, träckthäspäck.kicad_sch]
2026-11-12 final version
    [träckthäspäck.csv, träckthäspäck.kicad_pcb, träckthäspäck.kicad_sch]
